emb3rcia/ethernet-switch/3D/STEP/bottom_plate.step

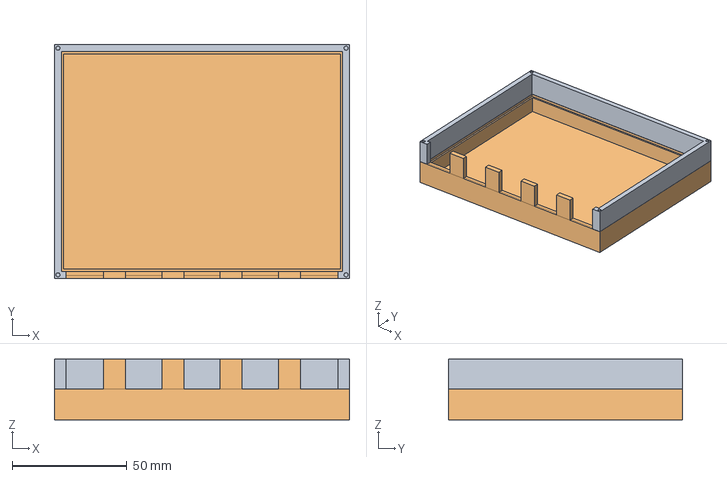
[picture p12: CAD file, 2026-02-28]
3D/STEP/bottom_plate.step
128.5 x 101.7 x 26.5 mm
