emb3rcia/ethernet-switch/3D/STEP/top_plate.step

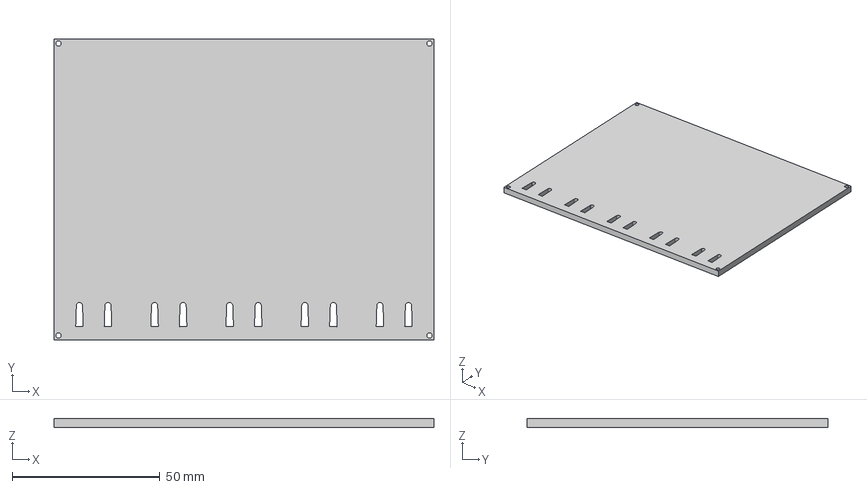
[picture p13: CAD file, 2026-02-28]
3D/STEP/top_plate.step
128.5 x 101.7 x 3.00 mm
