emb3rcia/ethernet-switch/(list of files, cad)

Other CAD files:
3D/Fusion 360/bottom_plate.f3d
3D/Fusion 360/top_plate.f3d
