emb3rcia/ethernet-switch/Firmware/ethernet_switch/ethernet_switch.ioc

Mcu.UserName=STM32F469BETx
PA1.Signal=ETH_REF_CLK
PA11.Signal=USB_OTG_FS_DM
PA12.Signal=USB_OTG_FS_DP
PA2.Signal=ETH_MDIO
PA4.GPIO_Label=SPI_CS
PA4.Signal=GPIO_Output
PA7.Signal=ETH_CRS_DV
PB11.Signal=ETH_TX_EN
PB12.Signal=ETH_TXD0
PB13.Signal=ETH_TXD1
PB14.GPIO_Label=SW_INT
PB14.Signal=GPXTI14
PB15.GPIO_Label=SW_PME
PB15.Signal=GPIO_Input
PB3.Signal=SPI1_SCK
PB4.Signal=SPI1_MISO
PB5.Signal=SPI1_MOSI
PC1.Signal=ETH_MDC
PC4.Signal=ETH_RXD0
PC5.Signal=ETH_RXD1
PD0.GPIO_Label=SW_RST
PD0.Signal=GPIO_Output
PH0/OSC_IN.Signal=RCC_OSC_IN
PH1/OSC_OUT.Signal=RCC_OSC_OUT
