emb3rcia/ethernet-switch/Firmware/ethernet_switch/Core/Inc/main.h

#define SPI_CS_Pin GPIO_PIN_4
#define SPI_CS_GPIO_Port GPIOA
#define SW_INT_Pin GPIO_PIN_14
#define SW_INT_GPIO_Port GPIOB
#define SW_PME_Pin GPIO_PIN_15
#define SW_PME_GPIO_Port GPIOB
#define SW_RST_Pin GPIO_PIN_0
#define SW_RST_GPIO_Port GPIOD
