emb3rcia/ethernet-switch/(commit log)

2026-02-24 Added /Images/Gerbers and /Licenses, made not complete README.md
2026-02-26 Added KSZ SPI functions
